jano2358/SoundLazer/SoundLazer/SoundLazer.png

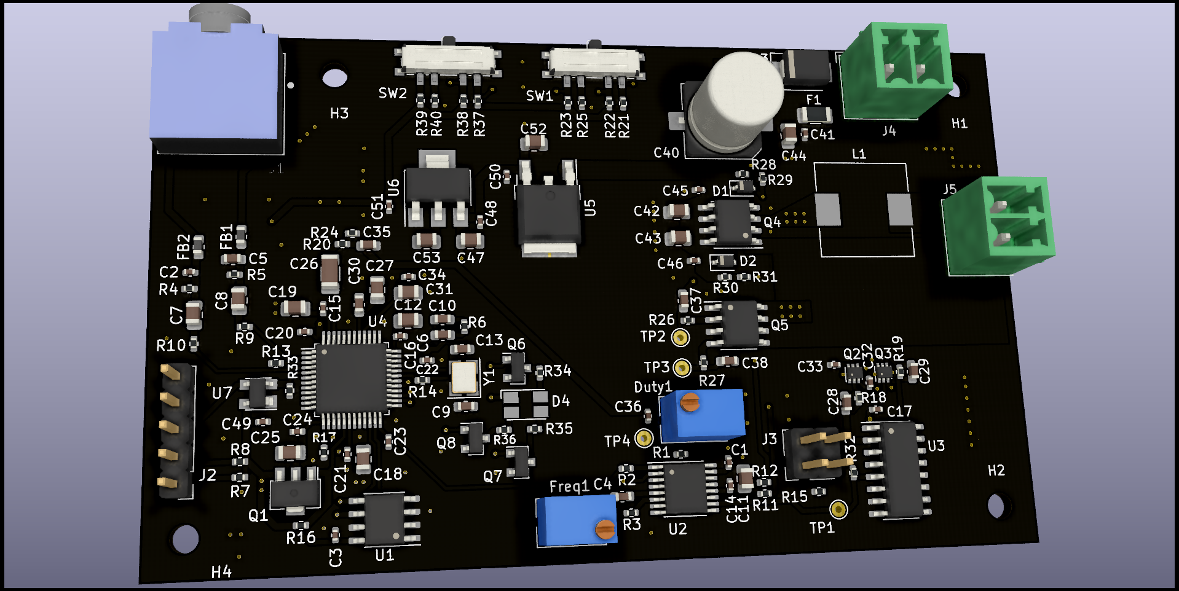
SoundLazer/SoundLazer.png
