jano2358/SoundLazer/Docu/SoundLazer.xlsx

Id | Quantity | Designation | Designator
1 | 1 | SJ1-3523N | J1
2 | 1 | 100u 6.3V | C26
3 | 2 | EG1381A | SW2,SW1
4 | 15 | 10k | R40,R39,R38,R37,R33,R32,R25,R23,R22,R21,R10,R9,R8,R7,R1
5 | 7 | 3.32k | R36,R35,R34,R31,R29,R17,R3
9 | 1 | DSP_PROG | J2
10 | 4 | M2.5 | H4,H3,H2,H1
8 | 1 | 24AA256-I/SN | U1
14 | 1 | MMDT2907V | Q3
15 | 1 | ABM8-12.288MHZ-B2-T | Y1
16 | 1 | CAT811STBI-GT3 | U7
17 | 1 | AZ1117-3.3 | U6
18 | 1 | MC78M06CDTRKG | U5
19 | 1 | ADAU1701 | U4
20 | 1 | HEF4049BT,653 | U3
21 | 1 | TL494 | U2
36 | 1 | FDS6890A | Q5
37 | 1 | MMDT2222V | Q2
38 | 1 | ZXTP25040DZTA | Q1
11 | 1 | FDS4935A | Q4
6 | 3 | 2N7002 | Q8,Q7,Q6
46 | 1 | SMBJ17A | D3
47 | 2 | MMDL914T1 | D2,D1
12 | 22 | 100n | C51,C50,C49,C48,C46,C45,C41,C36,C34,C33,C32,C24,C23,C22,C21,C20,C17,C16,C15,C14,C3,C1
13 | 1 | 100p | C2
39 | 1 | 56uH | L1
40 | 1 | SPK_OUT | J5
41 | 1 | 12V_IN | J4
42 | 1 | PWR_SEL | J3
43 | 2 | 10k | Freq1,Duty1
44 | 2 | 220 Ω@100MHz | FB2,FB1
45 | 1 | Fuse | F1
48 | 15 | 10u 35V | C53,C52,C47,C44,C43,C42,C31,C27,C25,C19,C18,C12,C11,C8,C7
49 | 1 | 220u 35V | C40
50 | 2 | 4.7µ 25V | C38,C37
51 | 2 | 56n | C35,C10
52 | 1 | 100n | C30
53 | 2 | 390p | C29,C28
54 | 2 | 27p | C13,C9
55 | 2 | 3.3n | C6,C4
56 | 1 | 100p | C5
26 | 2 | 274 | R30,R28
27 | 2 | 10 | R27,R26
28 | 4 | 49.9k | R24,R15,R5,R4
29 | 1 | 56.2 | R20
30 | 2 | 221 | R19,R18
31 | 1 | 1k | R16
32 | 2 | 100 | R14,R2
33 | 1 | 18.2k | R13
34 | 2 | 0 | R12,R11
35 | 1 | 475 | R6
