jano2358/SoundLazer/Docu/SL01_schematic.pdf

## GNDs join at C1-U1

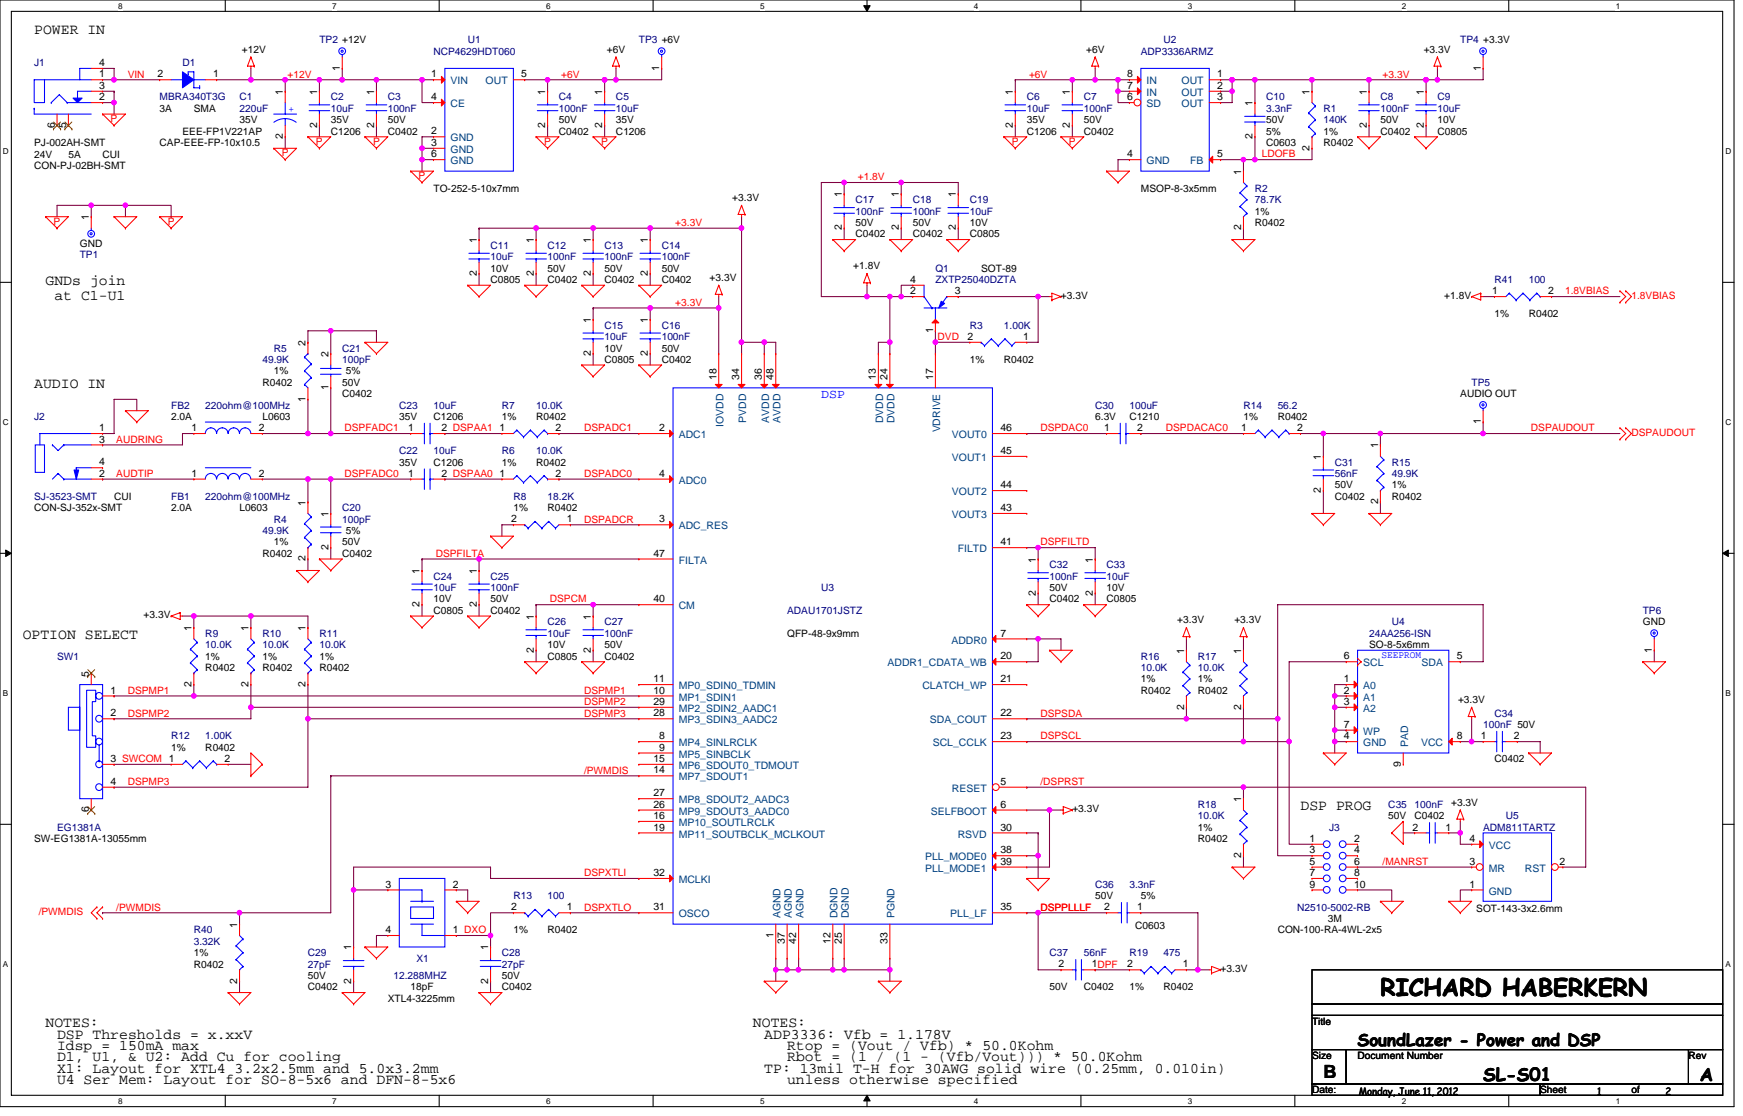
[picture p2: page 1]

R12 1.00K 1% R0402 3 SWCOM 1 2 | /PWMDIS | MP4_SINLRCLK 8 MP5_SINBCLK 9 MP6_SDOUT0_TDMOUT 15 MP7_SDOUT1 14 | DSPSCL

/DSPRST

NOTES:
DSP Thresholds = x.xxV
Rbot = (1 / (1 - (Vfb/Vout))) * 50.0Kohm Idsp = 150mA max
X1: Layout for XTL4 3.2x2.5mm and 5.0x3.2mm D1, U1, & U2: Add Cu for cooling
U4 Ser Mem: Layout for SO-8-5x6 and DFN-8-5x6

ADP3336: Vfb = 1.178V
Rtop = (Vout / Vfb) * 50.0Kohm
TP: 13mil T-H for 30AWG solid wire (0.25mm, 0.010in) unless otherwise specified

Title
SoundLazer - Power and DSP

Size Size Size B B B | Document Number Document Number Document Number SL-S01 SL-S01 SL-S01 | Rev Rev Rev A A A

Date: Date: Date: Monday, June 11, 2012 Monday, June 11, 2012 Monday, June 11, 2012 | Sheet Sheet Sheet 1 1 1 of of of 2 2 2

## DUTY CYCLE

## PWM

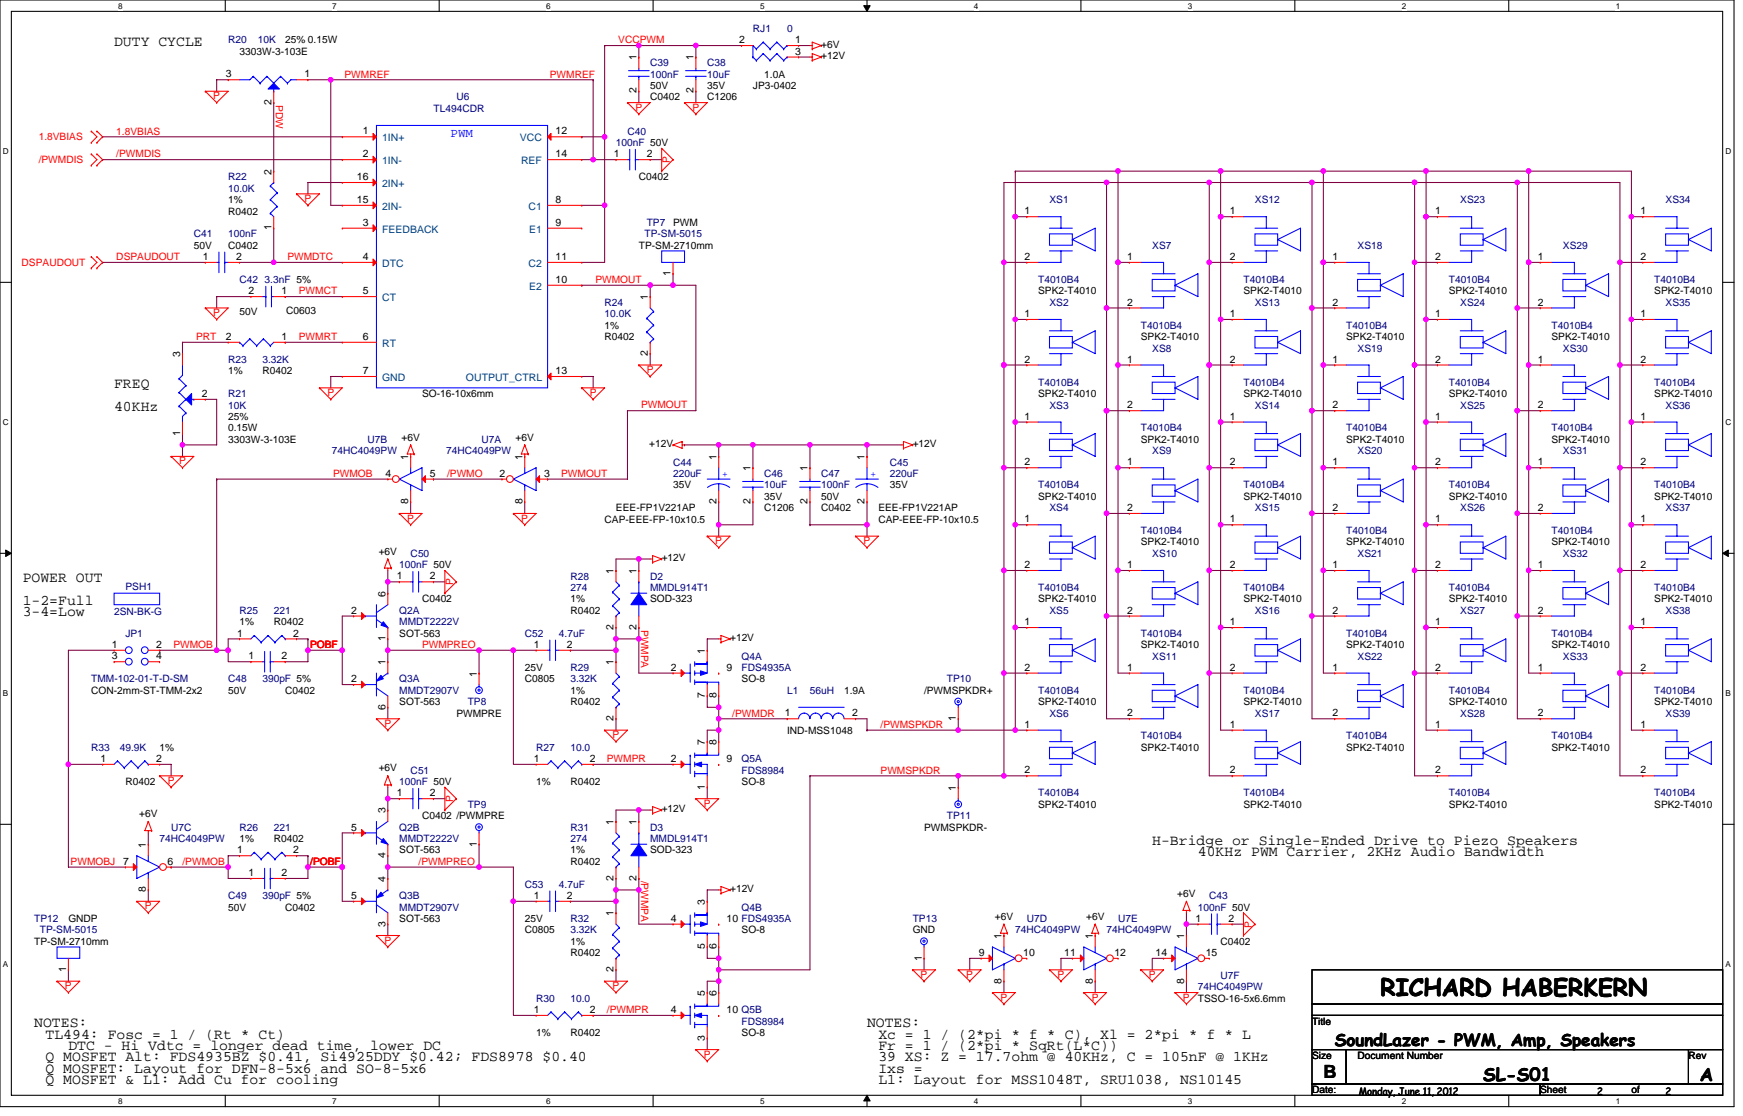
[picture p3: page 2]

H-Bridge or Single-Ended Drive to Piezo Speakers 40KHz PWM Carrier, 2KHz Audio Bandwidth

NOTES:
Q MOSFET Alt: FDS4935BZ $0.41, Si4925DDY $0.42; FDS8978 $0.40
Q MOSFET: Layout for DFN-8-5x6 and SO-8-5x6
Q MOSFET & L1: Add Cu for cooling

Title
SoundLazer - PWM, Amp, Speakers

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

Date: Date: Date: Monday, June 11, 2012 Monday, June 11, 2012 Monday, June 11, 2012 | Sheet Sheet Sheet 2 2 2 of of of 2 2 2
