jano2358/SoundLazer/SoundLazer/SoundLazer.kicad_pcb

## KiCad design SoundLazer/SoundLazer.kicad_pcb (2021-07-04)

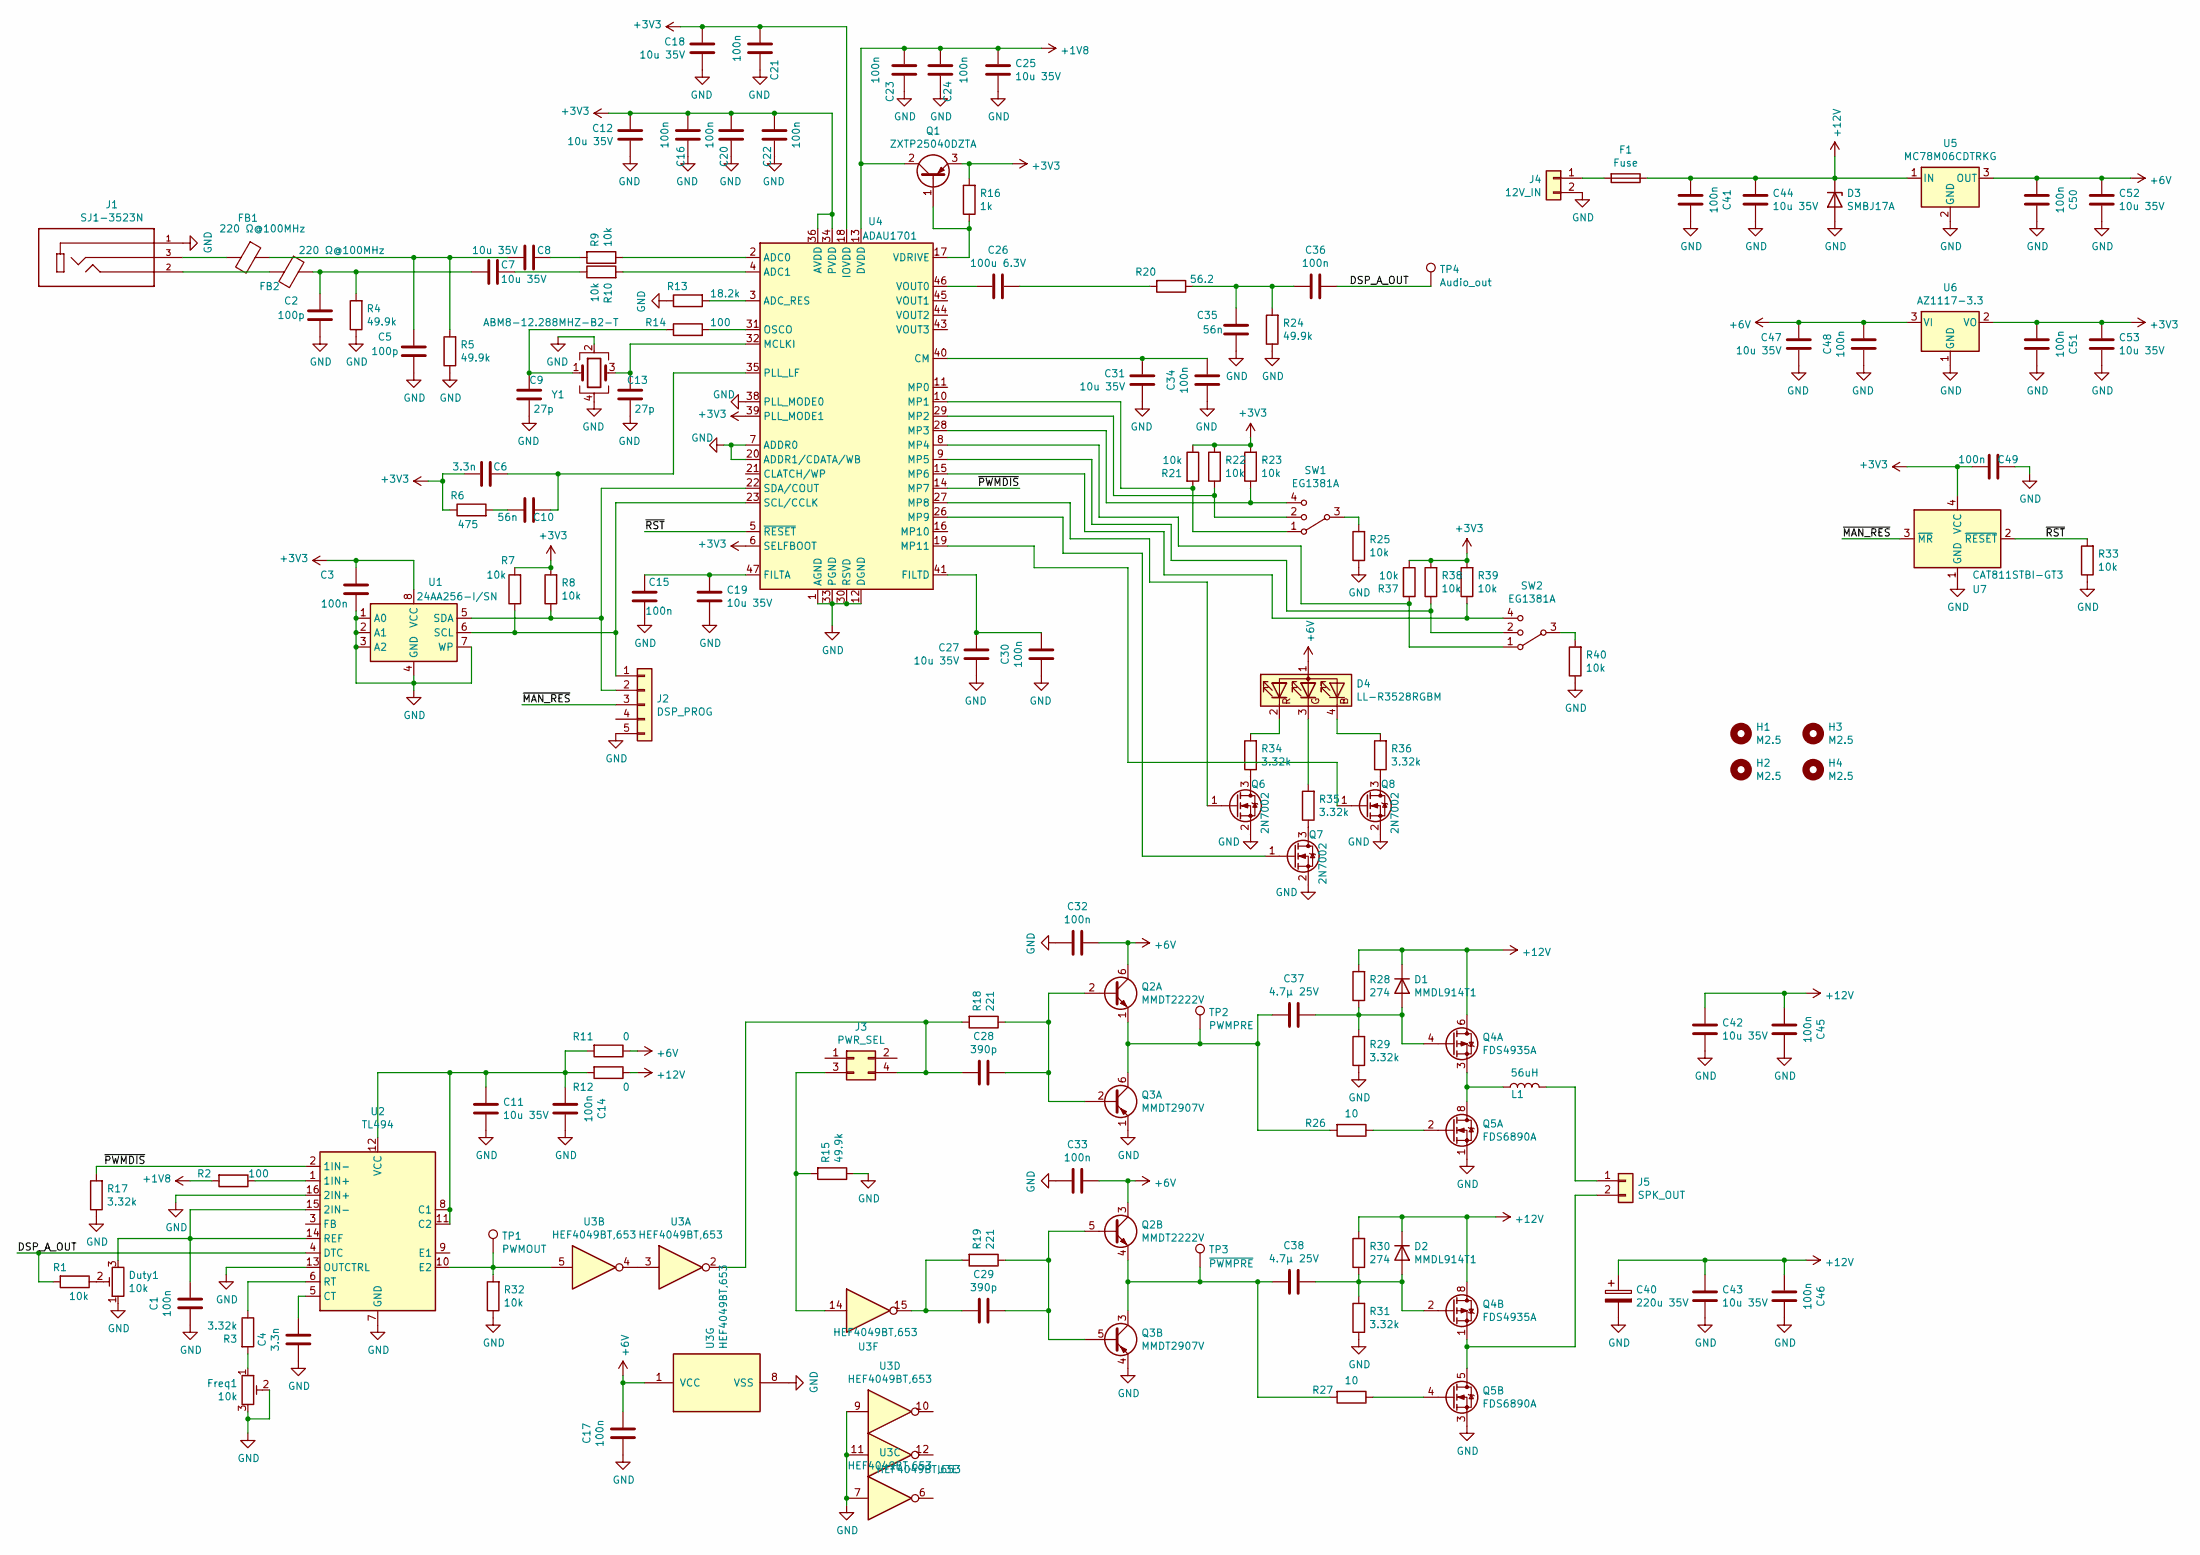
[picture p4: schematic SoundLazer.sch, SoundLazer PWM amplifier]

Parts:
C1, C3, C14, C15, C16, C17, C20, C21, C22, C23, C24, C32, C33, C34, C36, C41, C45, C46, C48, C49, C50, C51: 100n; C_0402_1005Metric
C2: 100p; C_0402_1005Metric
C4, C6: 3.3n; C_0603_1608Metric
C5: 100p; C_0603_1608Metric
C7, C8, C11, C12, C18, C19, C25, C27, C31, C42, C43, C44, C47, C52, C53: 10u 35V; C_0805_2012Metric
C9, C13: 27p; C_0603_1608Metric
C10, C35: 56n; C_0603_1608Metric
C26: 100u 6.3V; C_1206_3216Metric
C28, C29: 390p; C_0603_1608Metric
C30: 100n; C_0603_1608Metric
C37, C38: 4.7µ 25V; C_0603_1608Metric
C40: 220u 35V; C_Elec_8x10.2
D1, D2: MMDL914T1; D_SOD-323
D3: SMBJ17A; D_SMB
D4: LL-R3528RGBM; LED_Avago_PLCC4_3.2x2.8mm_CW
Duty1: 10k; Potentiometer_Bourns_3266Y_Vertical
F1: Fuse; Fuse_1206_3216Metric
FB1, FB2: 220 Ω@100MHz; L_0603_1608Metric
Freq1: 10k; Potentiometer_Bourns_3266Y_Vertical
H1, H2, H3, H4: M2.5; MountingHole_2.7mm_M2.5
J1: SJ1-3523N; CUI_SJ1-3523N; PARTREV 1.02
J2: DSP_PROG; PinHeader_1x05_P2.54mm_Vertical
J3: PWR_SEL; PinHeader_2x02_P2.54mm_Vertical
J4: 12V_IN; PhoenixContact_MCV_1,5_2-G-3.5_1x02_P3.50mm_Vertical; PartNumber 1713017
J5: SPK_OUT; PhoenixContact_MCV_1,5_2-G-3.5_1x02_P3.50mm_Vertical; PartNumber 1713017
L1: 56uH; L_10.4x10.4_H4.8
Q1: ZXTP25040DZTA; SOT-89-3
Q2: MMDT2222V; SOT-563
Q3: MMDT2907V; SOT-563
Q4: FDS4935A; SOIC-8_3.9x4.9mm_P1.27mm
Q5: FDS6890A; SOIC-8_3.9x4.9mm_P1.27mm
Q6, Q7, Q8: 2N7002; SOT-23
R1, R7, R8, R9, R10, R21, R22, R23, R25, R32, R33, R37, R38, R39, R40: 10k; R_0402_1005Metric
R2, R14: 100; R_0402_1005Metric
R3, R17, R29, R31, R34, R35, R36: 3.32k; R_0402_1005Metric
R4, R5, R15, R24: 49.9k; R_0402_1005Metric
R6: 475; R_0402_1005Metric
R11, R12: 0; R_0402_1005Metric
R13: 18.2k; R_0402_1005Metric
R16: 1k; R_0402_1005Metric
R18, R19: 221; R_0402_1005Metric
R20: 56.2; R_0402_1005Metric
R26, R27: 10; R_0402_1005Metric
R28, R30: 274; R_0402_1005Metric
SW1, SW2: EG1381A; SW_SP3T_PCM13
TP1: PWMOUT; TestPoint_THTPad_D1.5mm_Drill0.7mm
TP2: PWMPRE; TestPoint_THTPad_D1.5mm_Drill0.7mm
TP3: ~PWMPRE; TestPoint_THTPad_D1.5mm_Drill0.7mm
TP4: Audio_out; TestPoint_THTPad_D1.5mm_Drill0.7mm
U1: 24AA256-I/SN; SOIC-8_3.9x4.9mm_P1.27mm
U2: TL494; TSSOP-16_4.4x5mm_P0.65mm
U3: HEF4049BT,653; SOIC-16_3.9x9.9mm_P1.27mm
U4: ADAU1701; LQFP-48_7x7mm_P0.5mm
U5: MC78M06CDTRKG; TO-252-2
U6: AZ1117-3.3; SOT-223
U7: CAT811STBI-GT3; SOT-143
Y1: ABM8-12.288MHZ-B2-T; Crystal_SMD_Abracon_ABM8G-4Pin_3.2x2.5mm

Connections:
+1V8: C23.1, C24.2, C25.1, Q1.2 (C), R2.2, U4.13 (DVDD), U4.24 (DVDD)
+3V3: C3.2, C6.2, C12.1, C16.2, C18.1, C20.2, C21.2, C22.2, C49.1, C51.2, C53.1, Q1.3 (E), R6.1, R7.2, R8.2, R16.2, R21.1, R22.2, R23.2, R37.1, R38.2, R39.2, U1.8 (VCC), U4.6 (SELFBOOT), U4.18 (IOVDD), U4.34 (PVDD), U4.36 (AVDD), U4.39 (PLL_MODE1), U4.48 (AVDD), U6.2 (VO), U7.4 (VCC)
+6V: C17.1, C32.1, C33.1, C47.1, C48.2, C50.2, C52.1, D4.1 (A), Q2.3 (C2), Q2.6 (C1), R11.1, U3.1 (VCC), U5.3 (OUT), U6.3 (VI)
+12V: C40.1, C41.2, C42.1, C43.1, C44.1, C45.2, C46.2, D1.1 (K), D2.1 (K), D3.1 (K), F1.1, Q4.5 (D), Q4.6 (D), Q4.7 (D), Q4.8 (D), R12.1, R28.2, R30.2, U5.1 (IN)
/DSP_A_OUT: C36.1, R1.2, TP4.1, U2.4 (DTC)
/~MAN_RES: J2.3, U7.3 (~MR)
/~PWMDIS: R17.2, U2.2 (1IN-), U4.14 (MP7)
/~RST: R33.2, U4.5 (~RESET), U7.2 (~RESET)
GND: C1.2, C2.2, C3.1, C4.2, C5.2, C9.1, C11.2, C12.2, C13.1, C14.1, C15.1, C16.1, C17.2, C18.2, C19.2, C20.1, C21.1, C22.1, C23.2, C24.1, C25.2, C27.2, C30.1, C31.2, C32.2, C33.2, C34.1, C35.2, C40.2, C41.1, C42.2, C43.2, C44.2, C45.1, C46.1, C47.2, C48.1, C49.2, C50.1, C51.1, C52.2, C53.2, D3.2 (A), Duty1.1, Freq1.2, Freq1.3, J1.1, J2.5, J4.2, Q3.1 (E), Q3.4 (E), Q5.1 (S1), Q5.3 (S2), Q6.2 (S), Q7.2 (S), Q8.2 (S), R4.1, R5.1, R13.1, R15.1, R17.1, R24.1, R25.1, R29.1, R31.1, R32.1, R33.1, R40.1, U1.1 (A0), U1.2 (A1), U1.3 (A2), U1.4 (GND), U1.7 (WP), U2.7 (GND), U2.13 (OUTCTRL), U2.16 (2IN+), U3.7, U3.8 (VSS), U3.9, U3.11, U4.1 (AGND), U4.7 (ADDR0), U4.12 (DGND), U4.20 (ADDR1/CDATA/WB), U4.25 (DGND), U4.30 (RSVD), U4.33 (PGND), U4.37 (AGND), U4.38 (PLL_MODE0), U4.42 (AGND), U5.2 (GND), U6.1 (GND), U7.1 (GND), Y1.2, Y1.4
unnamed: C1.1, Duty1.3, U2.14 (REF), U2.15 (2IN-)
unnamed: C2.1, C7.2, FB2.1, R4.2
unnamed: C4.1, U2.5 (CT)
unnamed: C5.1, C8.2, FB1.1, R5.2
unnamed: C7.1, R10.1
unnamed: C8.1, R9.2
unnamed: C9.2, R14.1, Y1.1
unnamed: C6.1, C10.1, U4.35 (PLL_LF)
unnamed: C10.2, R6.2
unnamed: C11.1, C14.2, R11.2, R12.2, U2.8 (C1), U2.11 (C2), U2.12 (VCC)
unnamed: C13.2, U4.32 (MCLKI), Y1.3
unnamed: C15.2, C19.1, U4.47 (FILTA)
unnamed: C26.1, R20.2
unnamed: C26.2, U4.46 (VOUT0)
unnamed: C27.1, C30.2, U4.41 (FILTD)
unnamed: C28.1, Q2.2 (B1), Q3.2 (B), R18.1
unnamed: C28.2, J3.4, R18.2, U3.2
unnamed: C29.1, Q2.5 (B2), Q3.5 (B), R19.1
unnamed: C29.2, R19.2, U3.15
unnamed: C31.1, C34.2, U4.40 (CM)
unnamed: C35.1, C36.2, R20.1, R24.2
unnamed: C37.1, D1.2 (A), Q4.4 (G), R28.1, R29.2
unnamed: C37.2, Q2.1 (E1), Q3.6 (C), R26.2, TP2.1
unnamed: C38.1, D2.2 (A), Q4.2 (G), R30.1, R31.2
unnamed: C38.2, Q2.4 (E2), Q3.3 (C), R27.2, TP3.1
unnamed: D4.2 (RK), R34.2
unnamed: D4.3 (GK), R35.2
unnamed: D4.4 (BK), R36.2
unnamed: Duty1.2, R1.1
unnamed: F1.2, J4.1
unnamed: FB1.2, J1.3
unnamed: FB2.2, J1.2
unnamed: Freq1.1, R3.2
unnamed: J2.1, R7.1, U1.6 (SCL), U4.23 (SCL/CCLK)
unnamed: J2.2, R8.1, U1.5 (SDA), U4.22 (SDA/COUT)
unnamed: J3.3, R15.2, U3.14
unnamed: J5.1, L1.2
unnamed: J5.2, Q4.1 (S), Q5.5 (D2), Q5.6 (D2)
unnamed: L1.1, Q4.3 (S), Q5.7 (D1), Q5.8 (D1)
unnamed: Q1.1 (B), R16.1, U4.17 (VDRIVE)
unnamed: Q5.2 (G1), R26.1
unnamed: Q5.4 (G2), R27.1
unnamed: Q6.1 (G), U4.27 (MP8)
unnamed: Q6.3 (D), R34.1
unnamed: Q7.1 (G), U4.26 (MP9)
unnamed: Q7.3 (D), R35.1
unnamed: Q8.1 (G), U4.19 (MP11)
unnamed: Q8.3 (D), R36.1
unnamed: R2.1, U2.1 (1IN+)
unnamed: R3.1, U2.6 (RT)
unnamed: R9.1, U4.2 (ADC0)
unnamed: R10.2, U4.4 (ADC1)
unnamed: R13.2, U4.3 (ADC_RES)
unnamed: R14.2, U4.31 (OSCO)
unnamed: R21.2, SW1.1, U4.10 (MP1)
unnamed: R22.1, SW1.2, U4.29 (MP2)
unnamed: R23.1, SW1.4, U4.28 (MP3)
unnamed: R25.2, SW1.3
unnamed: R32.2, TP1.1, U2.10 (E2), U3.5
unnamed: R37.2, SW2.1, U4.8 (MP4)
unnamed: R38.1, SW2.2, U4.9 (MP5)
unnamed: R39.1, SW2.4, U4.15 (MP6)
unnamed: R40.2, SW2.3
unnamed: U3.3, U3.4

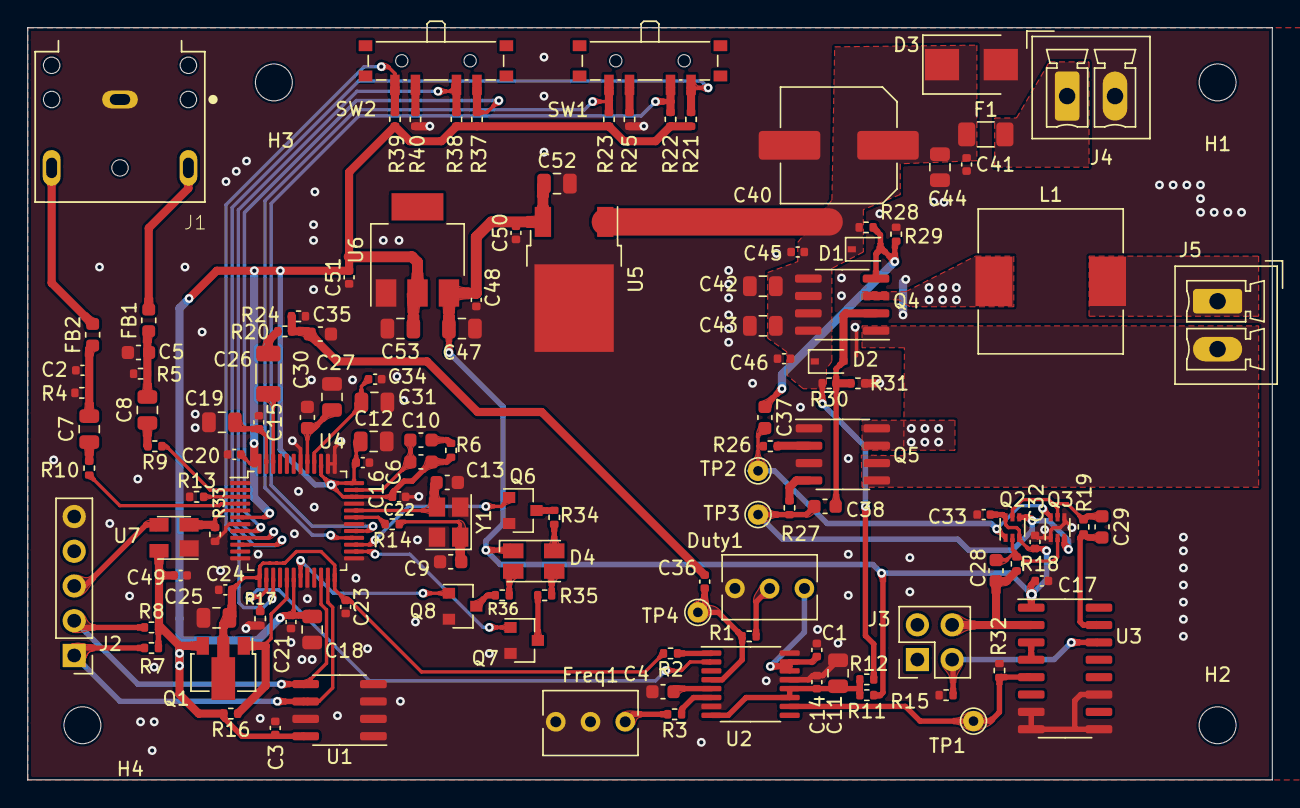
[picture p5: board SoundLazer.kicad_pcb from above]

Board: 2 copper layers, 91.0 x 55.0 mm, 133 parts (0 on the bottom side), 73 nets.
