jano2358/SoundLazer/(commit log)

2021-06-05 first revision
    [SoundLazer.sch]
2021-06-05 r20 corr
    [SoundLazer.sch]
2021-06-14 pcb update
    [SoundLazer.sch]
2021-07-04 gerbers ready
    [SLS01ABOM.xlsx, SLS01ABOM_1.xlsx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]
